daigo424/diegobot/README.md

# Diegobot

[日本語表記はこちら](README.ja.md)

A self-built differential-drive AMR (autonomous mobile robot). ROS 2 Jazzy + micro-ROS control the drivetrain, with teleop from a smartphone.

The long-term goal is to build something like a TurtleBot3 Waffle.

See [doc/wiring.md](doc/wiring.md) for hardware details.

| Find objects with YOLOE-26 |
| - |
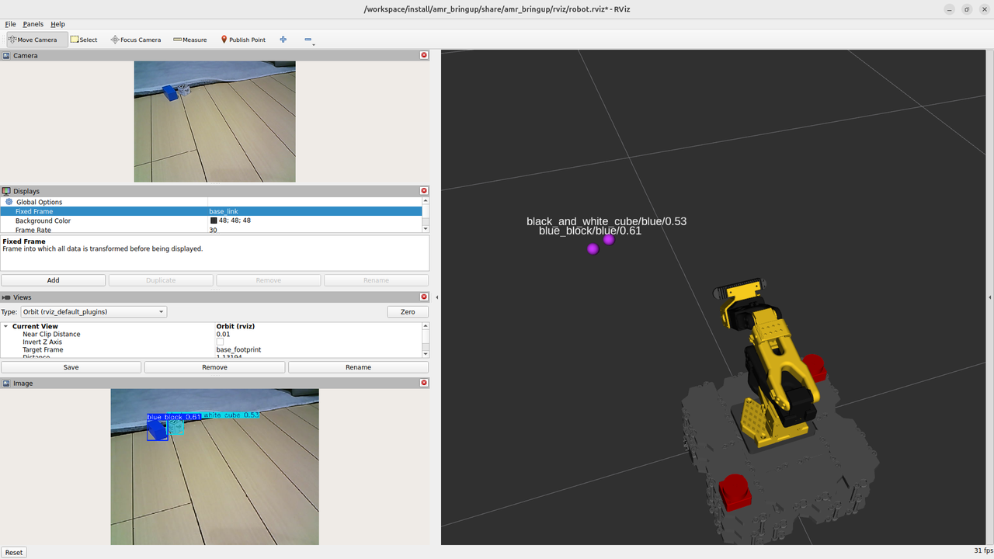
[picture p1: doc/images/find-objects-with-yolo.png]
|  |

https://github.com/user-attachments/assets/dc853809-cab7-45fa-803e-697c4c420df1

| Top side | Bottom side | Inside |
|-|-|-|
|  |  |  |

## Layout

```text
diegobot/
├── edge/
│   ├── docker/         # ROS 2 Jazzy image, rosbridge, micro-ROS Agent compose definitions
│   ├── workspace/      # ROS 2 workspace (colcon)
│   ├── esp32/          # ESP32 firmware (PlatformIO). Production + verification test firmwares (currently in use)
│   ├── pico/           # Pico firmware (PlatformIO). Production + verification test firmwares → edge/pico/README.md
│   └── provisioning/   # Raspberry Pi initial-setup automation + BLE Wi-Fi provisioning daemon → edge/provisioning/README.md
├── mobile/              # Flutter app "diegoctl" (BLE provisioning + joystick teleop)
├── doc/                 # Hardware documentation (wiring, etc.)
└── Makefile             # Entry point for dev/deploy operations
```

## Basic operations on the dev machine

```sh
make build          # Build the ROS 2 image
make up             # Start the containers (diegobot / rosbridge / micro-ros-agent)
make down           # Stop them
make login          # Enter the diegobot container
make vendor-import  # Fetch third-party packages listed in edge/workspace/vendor.repos (run after a fresh clone or when vendor.repos changes)
```

Motor check:

```sh
make teleop-twist-keyboard   # Drive by sending /cmd_vel from the keyboard
```

The `micro-ros-agent` service in `edge/docker/docker-compose.yml` takes the host's USB serial port (the microcontroller) from the `HOST_MICRO_ROS_PORT` environment variable (see `edge/.env.example`). Numbers like `/dev/ttyUSB*` can swap with the LiDAR depending on plug order, so specify the path under `/dev/serial/by-id/` instead (check with `ls -l /dev/serial/by-id/`).

## Microcontroller firmware

The robot currently runs on the ESP32 (`edge/esp32/`). `edge/pico/` is the equivalent Raspberry Pi Pico firmware, kept as an alternative target. Both are PlatformIO projects with the same layout: `src/production/main.hpp` is the production firmware, and `src/motor/`, `src/imu/` hold verification-test firmwares (switch them by editing the `#include` in `src/main.cpp`). See [edge/pico/README.md](edge/pico/README.md) for what each test does.

```sh
cd edge/esp32
pio run -t upload
```

## Deploying to the Raspberry Pi

```sh
make pi-rsync   # Copy the code over (vendor/ is excluded; it's third-party code managed by vcstool)
make pi-ssh     # SSH into the Pi
```

`vendor/` isn't copied by `pi-rsync`, so run `make vendor-import` on the Pi too (first time, or whenever `vendor.repos` changes).

See [edge/provisioning/README.md](edge/provisioning/README.md) for first-time setup on the Pi (installing Docker, making the BLE provisioning daemon persistent, etc.).

To cross-build the container image on the dev machine and ship it to the Pi (useful when building on the Pi itself is slow or runs out of memory):

```sh
make pi-push-image
```

## Mobile app (diegoctl)

`mobile/` contains a Flutter app with a BLE Wi-Fi provisioning screen and a joystick teleop screen that publishes `/cmd_vel` over rosbridge.

```sh
make android-install   # Build a release APK and install it on the connected device
```
