daigo424/diegobot/edge/workspace/src/amr_description/meshes/chassis_base.stl

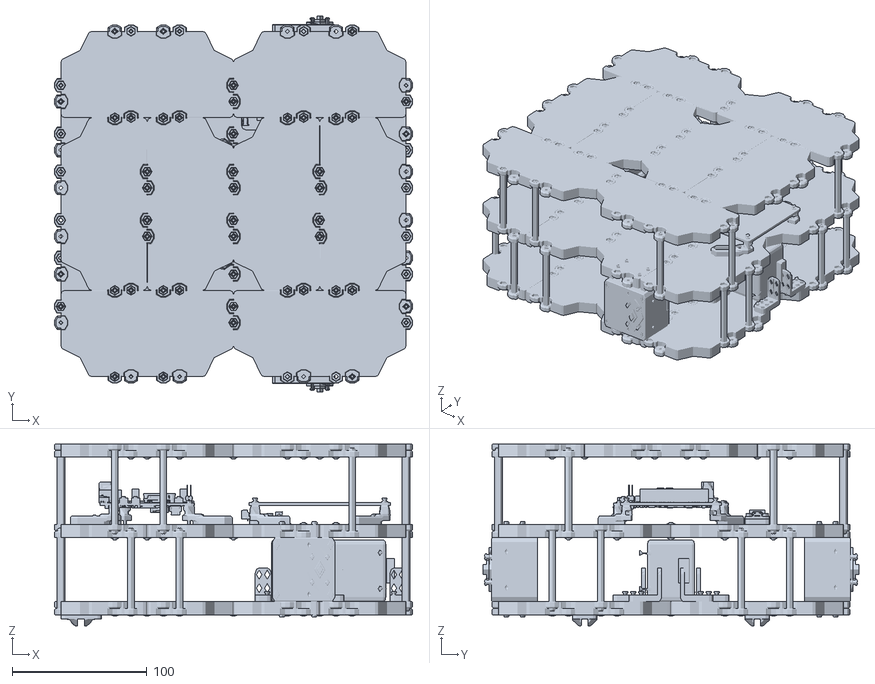
[picture p2: CAD file, 2026-11-02]
edge/workspace/src/amr_description/meshes/chassis_base.stl
265.5 x 278.8 x 134.8
