daigo424/diegobot/edge/workspace/src/amr_description/meshes/arm_camera_mount.stl

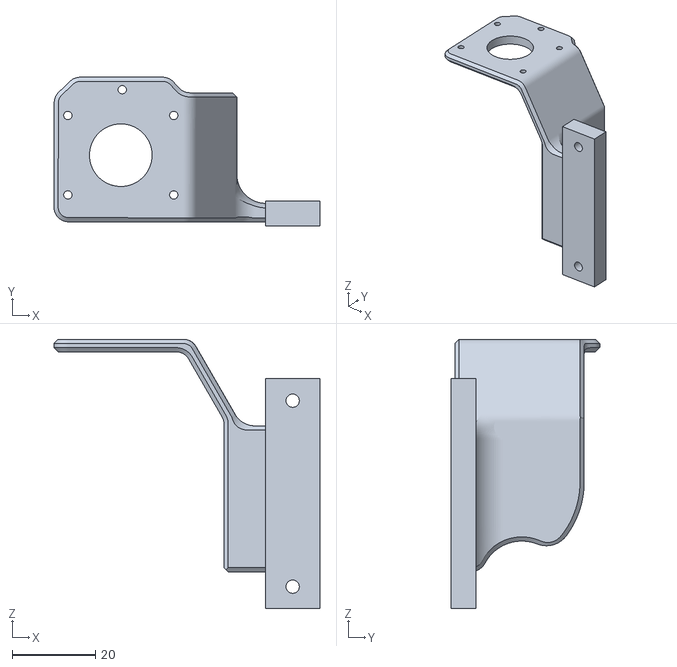
[picture p3: CAD file, 2026-10-31]
edge/workspace/src/amr_description/meshes/arm_camera_mount.stl
63.8 x 35.6 x 64.6
