daigo424/diegobot/edge/workspace/src/amr_description/meshes/arm_mount.stl

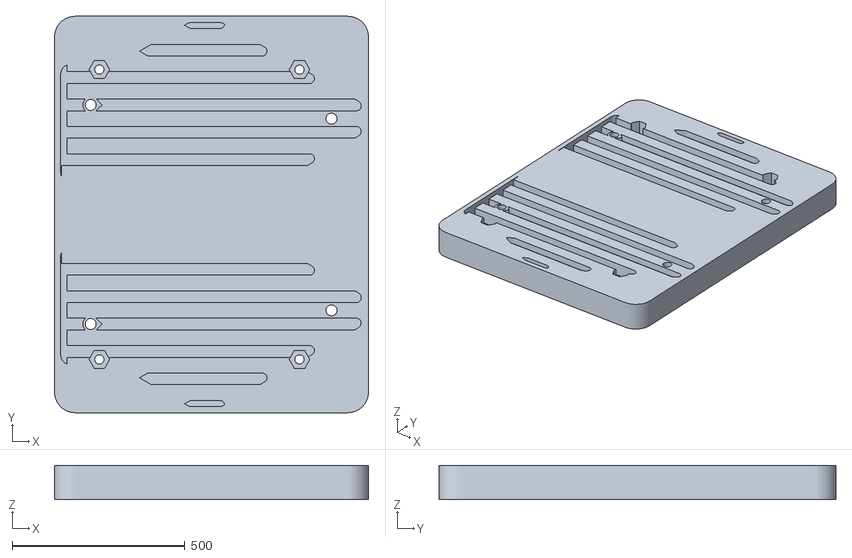
[picture p4: CAD file, 2026-10-27]
edge/workspace/src/amr_description/meshes/arm_mount.stl
910.0 x 1149.3 x 99.0
