daigo424/diegobot/edge/workspace/src/amr_bringup/textures/ground_place.png

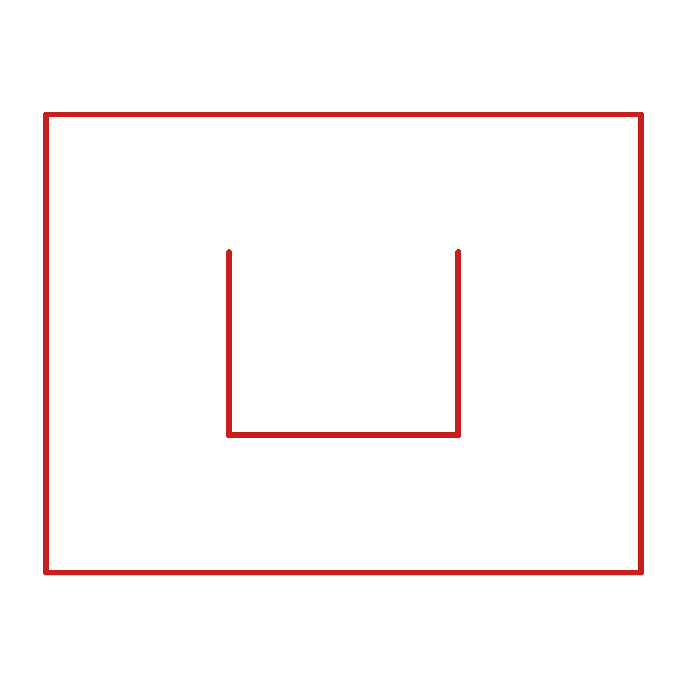
edge/workspace/src/amr_bringup/textures/ground_place.png
