daigo424/diegobot/edge/workspace/src/amr_description/urdf/chassis_base.urdf.xacro

<?xml version="1.0" ?>
<robot name="chassis_base" xmlns:xacro="http://ros.org/wiki/xacro">
  <xacro:arg name="namespace" default=""/>
  <xacro:property name="namespace" value="$(arg namespace)"/>
  <!-- base_linkから天板上面までの高さ(実測)。LiDARとアーム台座はこの面に載る。 -->
  <xacro:property name="chassis_top_z" value="0.1266"/>
  <!-- 実測。base_linkは下段の板の下面(床から9.45mm)、車軸は床から車輪半径の高さ。 -->
  <xacro:property name="base_link_z" value="0.00945"/>
  <xacro:property name="wheel_radius" value="0.034"/>
  <xacro:property name="wheel_width" value="0.026"/>

  <link name="base_footprint"/>

  <joint name="base_joint" type="fixed">
    <parent link="base_footprint"/>
    <child link="base_link" />
    <origin xyz="0 0 ${base_link_z}" rpy="0 0 0"/>
  </joint>

  <link name="base_link">
    <visual>
      <origin xyz="-0.064 0 0.0" rpy="0 0 0"/>
      <geometry>
        <mesh filename="package://amr_description/meshes/chassis_base.stl" scale="0.001 0.001 0.001"/>
      </geometry>
      <material name="light_black"/>
    </visual>

    <collision>
      <origin xyz="-0.064 0 ${chassis_top_z / 2}" rpy="0 0 0"/>
      <geometry>
        <box size="0.266 0.266 ${chassis_top_z}"/>
      </geometry>
    </collision>

    <inertial>
      <origin xyz="0 0 0" rpy="0 0 0"/>
      <mass value="1.3729096e+00"/>
      <inertia ixx="8.7002718e-03" ixy="-4.7576583e-05" ixz="1.1160499e-04" iyy="8.6195418e-03" iyz="-3.5422299e-06" izz="1.4612727e-02" />
    </inertial>
  </link>

  <joint name="${namespace}wheel_left_joint" type="continuous">
    <parent link="${namespace}base_link"/>
    <child link="${namespace}wheel_left_link"/>
    <origin xyz="0.035 0.1475 ${wheel_radius - base_link_z}" rpy="-1.57 0 0"/>
    <axis xyz="0 0 1"/>
  </joint>

  <link name="${namespace}wheel_left_link">
    <visual>
      <!-- Waffleのタイヤメッシュ(直径66mm・幅18.2mm、mmで幅がy)を実機の車輪の大きさへ拡大する。 -->
      <origin xyz="0 0 0" rpy="1.57 0 0"/>
      <geometry>
        <mesh filename="package://amr_description/meshes/left_tire.stl" scale="${wheel_radius / 33} ${wheel_width / 18.2} ${wheel_radius / 33}"/>
      </geometry>
      <material name="dark"/>
    </visual>

    <collision>
      <origin xyz="0 0 0" rpy="0 0 0"/>
      <geometry>
        <cylinder length="${wheel_width}" radius="${wheel_radius}"/>
      </geometry>
    </collision>

    <inertial>
      <origin xyz="0 0 0" />
      <mass value="2.8498940e-02" />
      <inertia ixx="1.1175580e-05" ixy="-4.2369783e-11" ixz="-5.9381719e-09" iyy="1.1192413e-05" iyz="-1.4400107e-11" izz="2.0712558e-05" />
      </inertial>
  </link>

  <joint name="${namespace}wheel_right_joint" type="continuous">
    <parent link="${namespace}base_link"/>
    <child link="${namespace}wheel_right_link"/>
    <origin xyz="0.035 -0.1475 ${wheel_radius - base_link_z}" rpy="-1.57 0 0"/>
    <axis xyz="0 0 1"/>
  </joint>

  <link name="${namespace}wheel_right_link">
    <visual>
      <origin xyz="0 0 0" rpy="1.57 0 0"/>
      <geometry>
        <mesh filename="package://amr_description/meshes/right_tire.stl" scale="${wheel_radius / 33} ${wheel_width / 18.2} ${wheel_radius / 33}"/>
      </geometry>
      <material name="dark"/>
    </visual>

    <collision>
      <origin xyz="0 0 0" rpy="0 0 0"/>
      <geometry>
        <cylinder length="${wheel_width}" radius="${wheel_radius}"/>
      </geometry>
    </collision>

    <inertial>
      <origin xyz="0 0 0" />
      <mass value="2.8498940e-02" />
      <inertia ixx="1.1175580e-05" ixy="-4.2369783e-11" ixz="-5.9381719e-09" iyy="1.1192413e-05" iyz="-1.4400107e-11" izz="2.0712558e-05" />
      </inertial>
  </link>

  <joint name="${namespace}caster_back_right_joint" type="fixed">
    <parent link="${namespace}base_link"/>
    <child link="${namespace}caster_back_right_link"/>
    <origin xyz="-0.177 -0.064 -0.004" rpy="-1.57 0 0"/>
  </joint>

  <link name="${namespace}caster_back_right_link">
    <collision>
      <origin xyz="0 0.001 0" rpy="0 0 0"/>
      <geometry>
        <box size="0.030 0.009 0.020"/>
      </geometry>
    </collision>

    <inertial>
      <origin xyz="0 0 0" />
      <mass value="0.005" />
      <inertia ixx="0.001" ixy="0.0" ixz="0.0" iyy="0.001" iyz="0.0" izz="0.001" />
    </inertial>
  </link>

  <joint name="${namespace}caster_back_left_joint" type="fixed">
    <parent link="${namespace}base_link"/>
    <child link="${namespace}caster_back_left_link"/>
    <origin xyz="-0.177 0.064 -0.004" rpy="-1.57 0 0"/>
  </joint>

  <link name="${namespace}caster_back_left_link">
    <collision>
      <origin xyz="0 0.001 0" rpy="0 0 0"/>
      <geometry>
        <box size="0.030 0.009 0.020"/>
      </geometry>
    </collision>

    <inertial>
      <origin xyz="0 0 0" />
      <mass value="0.005" />
      <inertia ixx="0.001" ixy="0.0" ixz="0.0" iyy="0.001" iyz="0.0" izz="0.001" />
    </inertial>
  </link>

  <joint name="${namespace}imu_joint" type="fixed">
    <parent link="${namespace}base_link"/>
    <child link="${namespace}imu_link"/>
    <origin xyz="-0.11 0 0.09" rpy="0 0 ${pi}"/>
  </joint>

  <link name="${namespace}imu_link">
    <visual>
      <origin xyz="0 0 0" rpy="0 0 0"/>
      <geometry>
        <box size="0.0212 0.0164 0.0033"/>
      </geometry>
      <material name="blue"/>
    </visual>
  </link>

  <xacro:include filename="t_mini_plus_12.urdf.xacro" />
  <xacro:t_mini_plus_12 name="${namespace}lidar_front_right" parent="${namespace}base_link" xyz="0.022 -0.104 ${chassis_top_z}" rpy="0 0 0"/>
  <xacro:t_mini_plus_12 name="${namespace}lidar_rear_left" parent="${namespace}base_link" xyz="-0.150 0.104 ${chassis_top_z}" rpy="0 0 ${pi}"/>

</robot>
