daigo424/diegobot/edge/workspace/src/amr_bringup/config/controllers.yaml

controller_manager:
  ros__parameters:
    update_rate: 100  # Hz

    joint_state_broadcaster:
      type: joint_state_broadcaster/JointStateBroadcaster

    diff_drive_controller:
      type: diff_drive_controller/DiffDriveController

    arm_controller:
      type: position_controllers/JointGroupPositionController

diff_drive_controller:
  ros__parameters:
    left_wheel_names: ["wheel_left_joint"]
    right_wheel_names: ["wheel_right_joint"]

    wheel_separation: 0.295
    wheel_radius: 0.034

    publish_rate: 50.0
    odom_frame_id: odom
    base_frame_id: base_footprint

    open_loop: false
    enable_odom_tf: true

    cmd_vel_timeout: 0.5
    use_stamped_vel: false

arm_controller:
  ros__parameters:
    joints: [shoulder_pan, shoulder_lift, elbow_flex, wrist_flex, wrist_roll, gripper]
