daigo424/diegobot/edge/workspace/src/amr_moveit_config/config/joint_limits.yaml

# joint_limits.yaml allows the dynamics properties specified in the URDF to be overwritten or augmented as needed

# For beginners, we downscale velocity and acceleration limits.
# You can always specify higher scaling factors (<= 1.0) in your motion requests.  # Increase the values below to 1.0 to always move at maximum speed.
default_velocity_scaling_factor: 0.5
default_acceleration_scaling_factor: 0.5

# Specific joint properties can be changed with the keys [max_position, min_position, max_velocity, max_acceleration]
# Joint limits can be turned off with [has_velocity_limits, has_acceleration_limits]

# Hand-tuned after MoveIt Setup Assistant (regenerating overwrites these):
# Limits match what feetech_ros2_driver 0.2.2 sends with every goal: speed 2400 steps/s (3.68 rad/s) and acceleration 50 x 8.7 deg/s^2 (7.6 rad/s^2).
# AddTimeOptimalParameterization cannot build a trajectory if any joint lacks an acceleration limit.
joint_limits:
  elbow_flex:
    has_velocity_limits: true
    max_velocity: 3.6
    has_acceleration_limits: true
    max_acceleration: 7.5
  gripper:
    has_velocity_limits: true
    max_velocity: 3.6
    has_acceleration_limits: true
    max_acceleration: 7.5
  shoulder_lift:
    has_velocity_limits: true
    max_velocity: 3.6
    has_acceleration_limits: true
    max_acceleration: 7.5
  shoulder_pan:
    has_velocity_limits: true
    max_velocity: 3.6
    has_acceleration_limits: true
    max_acceleration: 7.5
  wrist_flex:
    has_velocity_limits: true
    max_velocity: 3.6
    has_acceleration_limits: true
    max_acceleration: 7.5
  wrist_roll:
    has_velocity_limits: true
    max_velocity: 3.6
    has_acceleration_limits: true
    max_acceleration: 7.5
