daigo424/diegobot/(commit log)

2026-09-10 🌱 first commit
2026-09-13 refactor: organize and integrate code by sensor type
2026-09-13 feat: implement IMU for MPU6050
2026-09-15 feat: implement Camera for IMX708
2026-09-15 feat: implement simulation
    [amr.urdf.xacro, common_properties.xacro, controllers.yaml, imx708_camera.urdf, imx708_camera_gazebo.urdf, ros2_control.urdf, turtlebot3_burger.urdf]
2026-09-18 feat: add wheel odometry and EKF sensor fusion
    [imx708_camera.urdf, imx708_camera_gazebo.urdf]
2026-10-02 fix: skip unavailable camera devices in docker compose
2026-10-13 feat: change to use ESP32 from PICO
2026-10-23 feat: start containers on device boot via systemd
2026-10-26 feat: add RGB-D camera and server-side object detection
2026-10-27 feat: add SO-101 arm and HP60C RGB-D camera to robot model and simulation
2026-10-27 feat: add MoveIt config for SO-101 arm
2026-10-27 feat: adjust params of MoveIt config for SO-101 arm
2026-10-28 feat: drive the real SO-101 arm from MoveIt with auto-start, standby pose and collision geometry
2026-10-31 fix: lower micro-ROS serial baud to 460800 to stop stalls on Raspberry Pi 5
2026-10-31 feat: replace the Waffle LiDAR with two YDLIDAR T-mini Plus units on the chassis
2026-11-01 feat: update URDFs
2026-11-01 feat: auto-start the real robot's sensors and EKF, and view them in RViz
2026-11-01 feat: merge both LiDAR scans into /scan with the chassis filtered out
2026-11-02 feat: pick objects found by text query with the arm
2026-11-02 feat: search for, approach and place objects with arm and base
2026-11-05 fix: reopen the depth camera when most depth pixels drop out
2026-11-06 fix: keep two seconds of frames to pair color and depth
2026-11-06 fix: judge depth dropout only when the camera looks down from high
